rabbits-robotics/gamma_neck_pcb/docs/2026-08-12-gamma-neck-spec.md

# gamma_neck基板 設計スペック

日付: 2026-08-12
状態: **spec最終版（2026-08-12・案A承認済み・12回路割付確定・PH6P衝突はリスク受容・CAN1デバッグ口は不採用）**。残件: MHF5005最終確認（線序候補あり）・リング定格数値・コネクタ秋月コード・基板サイズ
KiCadプロジェクト: このフォルダの `gamma_neck.kicad_pro` を新設計で置き換える（現内容はコピーの名残・旧ガーバーはgbr_*.zipに保存済み）

## 1. 役割

マイコンなしの**受動基板**。砲塔側で以下を担う:
1. スリップリング（車体⇔砲塔）のリード線の受け口
2. 24V駆動電源の分配（首モータ3台・P4キャリア）
3. CANバスの分配（CAN1=砲塔系を首モータへ、CAN2=車体系をP4へパススルー）
4. 競技用ゲームモジュール線（4ピン）のパススルー

システム文脈: network_gamma.drawio参照。首=DM3507×2（Roll/Pitch）＋MHF5005（Yaw）の3軸ジンバル、制御はP4キャリア（gamma_turret）のCAN1。

## 2. 入出力とコネクタ

| 方向 | 系統 | コネクタ | 備考 |
|---|---|---|---|
| 入力（スリップリングから） | 24V駆動電源 | **PH 6P（24V×3+GND×3）確定** | リング12回路割付: 電源6・CAN2×2・PA4。旧Vin1と同構造。**PH3ピン並列=6A連続 — 合算負荷は紙上超過の可能性あるが実効平均の低さと旧構成実績でリスク受容（2026-08-12）** |
| 〃 | CAN2（車体バス） | PH 2P | |
| 〃 | ゲームモジュール線 | **PA 4P**（競技指定規格。電源2＋通信2） | |
| 出力 | DM3507 Roll用 電源 | **XT30メス** | **達妙転換板（SH1.0→XT30+GH1.25）経由に変更（2026-08-12）** — モータ側ピン数の疑問（8pin表記とユーザー認識6pinの食い違い）を転換板が吸収。XT30の15A級でピーク8.3Aも余裕 |
| 〃 | DM3507 Roll用 CAN1 | **PH 2P**（1=H/2=L） | 転換板のGH1.25出口を従来方式でPH化 |
| 〃 | DM3507 Pitch用 電源 | **XT30メス** | Roll同様 |
| 〃 | DM3507 Pitch用 CAN1 | **PH 2P** | Roll同様 |
| 〃 | MHF5005 Yaw用（電源+CAN1） | **PH 6P** | 転換板が無いため6pin直受け（1対1圧着）。電源2並列=4A — MHF5005の電流値確認後に検算 |
| 〃 | P4キャリアへ 24V | XT30（メス=供給側の作法） | P4側は24Vin1（XT30PW-Mオス） |
| 〃 | P4キャリアへ CAN1 | PH 2P | P4側CAN1コネクタ（PH2P）と対 |
| 〃 | P4キャリアへ CAN2 | PH 2P | パススルー中継 |
| 〃 | 競技モジュールへ | PA 4P | パススルー |
| 搭載（確定） | 24V通電LED | 緑LED＋10kΩ直列 | **turretと同色ルール（緑=電源）**。緑OSG5TA3Z74A（[秋月111635](https://akizukidenshi.com/catalog/g/g111635/)）を**1個追加購入**（turret D1は単品購入のため余りなし）。24Vで約2.1mA・抵抗損失44mW=1/4W可 |

## 3. CAN終端の方針（確定）

- **この基板には終端抵抗を載せない**
- CAN1: **モータ内蔵の切替式終端で運用**（DM3507=内蔵・デフォルトON〔マニュアル確認済み: 「终端电阻开关，默认打开」〕、MHF5005=切替可能〔ユーザー確認〕）。**運用ルール: バス最遠の1台のみON・他はOFF**。デフォルトONのまま3台繋ぐと120Ω×4並列=30Ωで規格外になるため、組立時のスイッチ確認を必須手順とする
- CAN2: 両端終端は車体側とP4キャリア（R9）が担当。この基板は分岐のみ

## 4. 設計上の注意

- 24V大電流経路（スリップリング入力→モータ3分岐＋P4分岐）は太パターン/ベタ。P4分岐はP4のDCDCout経由でESC×2＋サーボの電流も流れる点に注意
- PHの電源ピンは2A/ピン。並列本数×2Aで各口を検算（4.5節・上表に記載済み）。**コネクタ構成はP4向けXT30メスとゲームPA 4Pを除き全てPHファミリーに統一（2026-08-12）**
- 誤挿し対策: P4向けXT30はメス（供給側）で向き分け。PH 8P（DM3507×2）とPA 4Pはピン数で排除
- **⚠️リスク受容（2026-08-12ユーザー判断）**: リング電源入力とMHF5005出力が同じPH 6P — 挿し違えるとモータのCANピンに24V。対策なし・シルク表記＋組立時確認で運用担保
- PH 2P同士（CAN2入力・P4向けCAN1/CAN2）の挿し違えはCAN同士のため実害小（通信不成立のみ・破損なし）

## 4.5 DM3507実測仕様（2026-08-12マニュアル確認済み）

- **電源+CAN端子（SH1.0 8pin）の線序: 1〜3=VCC(24V)並列／4〜6=GND並列／7=CAN_L／8=CAN_H** → PH 8Pへ1対1付け替えでそのまま基板ピン配列になる
- **定格電源電流3.0A・ピーク8.3A/台**（額定0.8Nm・峰値3Nm・減速7:1）
- PH電源容量検算: 3ピン並列×2A=6A ≥ 定格3A → 成立（ピーク8.3Aは瞬時のため許容と判断）
- 終端抵抗: 物理スイッチOFF/ON式・デフォルトON（p3図で確認）
- 注意: マニュアルp2の付属品リストは8pin/3pinの記載が逆（誤記）。p3の接口説明が正: 電源+CAN=8pin、調試串口=3pin
- モータ搭載穴: 4×M3、外径46mm・高37.9mm・150g

## 5. 未確認事項（設計前に埋める）

1. ~~DM3507の線序~~ → **転換板経由に変更したため基板設計上は不問に（2026-08-12）**。8pin/6pinの食い違い（マニュアルp3=8pin図 vs ユーザー認識6pin）は現物確認を組立時に
2. MHF5005の6ピン線序 → **有力候補確定（旧gamma_neck基板の実績配線）: 1=CAN_L/2=CAN_H/3=GND/4=GND/5=24V/6=24V**。マニュアルで最終確認＋定格・ピーク電流の取得のみ残
2b. **CAN2の車体側終端の所在確認（新規）** — 旧システムは旧neck基板のR2が唯一のCAN2終端だった形跡（旧chassis/fuse_boxに終端なし）。新体制ではP4のR9が砲塔側終端になるため、車体側終端をどこが担うか（DM系ESC内蔵スイッチ等）の確認が必要
3. スリップリング → **12回路・割付確定（電源6/CAN2×2/PA4、2026-08-12）**。残るは**回路あたり定格電流の確認のみ**: 一般的な12回路カプセル品の2A/回路と仮定すると電源容量6A連続。DM3507×2の定格合算(6A)と同水準のため、型番判明次第数値を差し替える。※ジンバル用途の実効平均電流は定格よりかなり低いのが通例で、瞬時バーストはリングの熱容量で吸収される見込みだが、連続高負荷（保持トルク張り付き）時は注意
4. ~~秋月在庫~~ → **確定（2026-08-12・全て在庫あり）**:
   - PH 6P B6B-PH-K-S ×2（リング電源入力・MHF5005用）: [112806](https://akizukidenshi.com/catalog/g/g112806/)・¥15
   - PH 2P B2B-PH-K-S ×5（CAN2入力・P4向けCAN1/CAN2・Roll/Pitch CAN）: [112802](https://akizukidenshi.com/catalog/g/g112802/)・¥10
   - PA 4P B04B-PASK ×2（リング側・モジュール側）: [115012](https://akizukidenshi.com/catalog/g/g115012/)・¥20（ハーネス用ハウジングPAP-04V-S: [115009](https://akizukidenshi.com/catalog/g/g115009/)）
   - XT30PW-F ×3（P4向け24V出力・Roll/Pitch電源）: [117948](https://akizukidenshi.com/catalog/g/g117948/)・¥70
   - ※PH横出し（S□B）の多ピンは秋月非取扱のため**トップ型（縦）前提**。横出しが必須になったら要再検討
5. 基板サイズ・取付穴（首まわりの搭載スペース）
6. ゲームモジュール4ピンの通信種別（パススルーなので設計には影響しないが、記録として）

## 6. 実装方式の選択肢（→案Aで承認済み）

- **案A: 純受動・最小構成（採用）**: 上表のコネクタ＋太パターン＋24V通電LED（CAN1デバッグ口は2026-08-12不採用）
- 案B: 保守機能つき（各モータ電源にポリスイッチ・予備パッド追加）
- 案C: 割り切り軽量（スリップリング直はんだ）— 整備性が犠牲

## 7. 進め方（承認後）

gamma_turretと同じワークフロー: ユーザーがKiCadで手描き（当方はKiCadファイルに書き込まない）→ expected_nets.csv方式の結線照合＋ERC読み取り検証 → フットプリント全数監査 → レイアウト。
