rabbits-robotics/gamma_neck_pcb/docs/回路図作成リファレンス.md

# gamma_neck 回路リファレンス（現状版）

2026-08-12全面改訂: **完成した回路図の実際のrefdes・結線から生成**（照合済み: OK all nets match）。
設計判断の経緯は `2026-08-12-gamma-neck-spec.md`。初版（提案refdes版）はgit履歴参照。

## 1. 部品表（全15点・実際のrefdes）

| Ref | 部品 | フットプリント | 購入品 |
|---|---|---|---|
| Vin1 | リング電源入力 PH6P横 | `Connector_JST:JST_PH_S6B-PH-K_1x06_P2.00mm_Horizontal` | **[S6B-PH-K-S（千石EEHD-55FE・¥42/10個〜）](https://www.sengoku.co.jp/mod/sgk_cart/detail.php?code=EEHD-55FE)** ※秋月非取扱・生産遅延注記あり店頭在庫要確認 |
| YawMotor1 | MHF5005用 PH6P横 | 同上 | 同上（計2個） |
| Vout1〜Vout3 | 24V出力 XT30メス横×3（P4・Roll電源・Pitch電源） | `Connector_AMASS:AMASS_XT30PW-F_1x02_P2.50mm_Horizontal` | [XT30PW-F（秋月117948・¥70）](https://akizukidenshi.com/catalog/g/g117948/)×3 |
| CAN1_a/b/c | CAN1口×3（Roll・Pitch・P4） | `Connector_JST:JST_PH_B2B-PH-K_1x02_P2.00mm_Vertical` | [B2B-PH-K-S（秋月112802・¥10）](https://akizukidenshi.com/catalog/g/g112802/)×3 |
| CAN2_a1/b1 | CAN2パススルー（リング側/P4側） | 同上 | 同上×2 |
| GAME_MODULE | PA4P **1口・電気的未接続（確定）** | `User:JST_PA_B04B-PASK_1x04_P2.00mm_Vertical`（自作・検証済み・爪側シルク付き） | [B04B-PASK（秋月115012・¥20）](https://akizukidenshi.com/catalog/g/g115012/) |
| R1 | 120Ω CAN1終端 **DNP予定** | `Resistor_THT:R_Axial_DIN0204_L3.6mm_D1.6mm_P5.08mm_Horizontal` | 手持ちCF25J |
| R2 | 120Ω CAN2終端 **必ずDNP** | 同上 | 同上 |
| R3 | LED直列 **⚠️要修正: 1k→10k** | 同上 | 同上 |
| D1 | 24V通電LED 緑 | `LED_THT:LED_D3.0mm` | [OSG5TA3Z74A（秋月111635・¥20）](https://akizukidenshi.com/catalog/g/g111635/) |

**価格比較の結論（2026-08-12）**: 千石のPH系は一律¥42/個（10個〜）で、秋月在庫品（¥10〜15）より3〜4倍高い → **リンク差し替え対象なし。千石調達はS6B-PH-K-S（秋月非取扱品）のみ**。

## 2. 結線（照合済みの実体）

| ネット | 接続 |
|---|---|
| +24V | Vin1.4-6／Vout1-3の各2番／YawMotor1.5-6／R3.1 |
| GND | Vin1.1-3／Vout1-3の各1番／YawMotor1.3-4／D1.1 |
| CAN_H | CAN1_a/b/cの各1番／YawMotor1.2／R1.1 |
| CAN_L | CAN1_a/b/cの各2番／YawMotor1.1／R1.2 |
| CAN2（無名2本） | CAN2_a1⇔CAN2_b1の1番同士・2番同士＋R2 |
| LED | +24V→R3→D1(A)、D1(K)→GND |
| GAME_MODULE | 全ピン未接続（NC・ユーザー確定: ゲーム線は基板パターンを経由しない） |

## 3. 残作業（2026-08-12レビュー指摘）

1. **🔴 R3の値を1k→10kへ**（24Vで22mA・0.5W焼損リスク。10kで2.2mA/48mW）
2. **🟡 R1・R2にDNPフラグ**（プロパティ→「実装しない」。R2は必ずDNP。R1は「実装してモータ側全OFF運用」への変更も選択肢 — 決めたらspecに記録）
3. アノテーション警告（数字なしref: GAME_MODULE等）— 実害なし・任意

## 4. 検証

```bash
cd C:\Users\kota0\Desktop\Rabbits\board_ws\gamma_neck
python check_nets.py
```
現状: **OK: all nets match**（36接続）。ERCエラー2件（+24V/GND電源未駆動）は許容ベースライン。
