rabbits-robotics/gamma_neck_pcb/gamma_neck.step

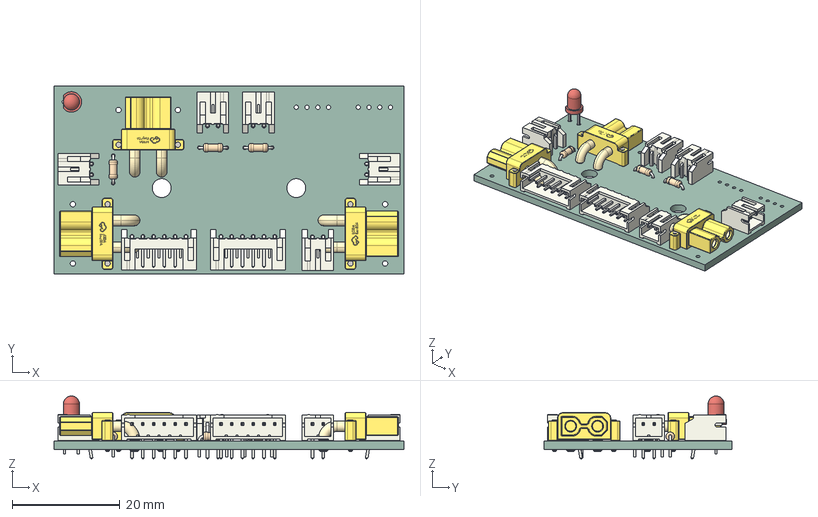
[picture p1: CAD file, 2026-10-18]
gamma_neck.step
65.0 x 35.0 x 11.7 mm
R_Axial_DIN0204_L36mm_D16mm_P508mm_Horizontal x 3
CONN-TH_XT30PW-F-1 x 3
JST_S2B_PH_K x 5
JST_S6B_PH_K x 2
LED_D3.0mm
gamma_neck_PCB
