rabbits-robotics/gamma_neck_pcb/(list of files, cad)

Other CAD files:
gamma_neck.DXF
