rabbits-robotics/gamma_neck_pcb/gamma_neck.pdf

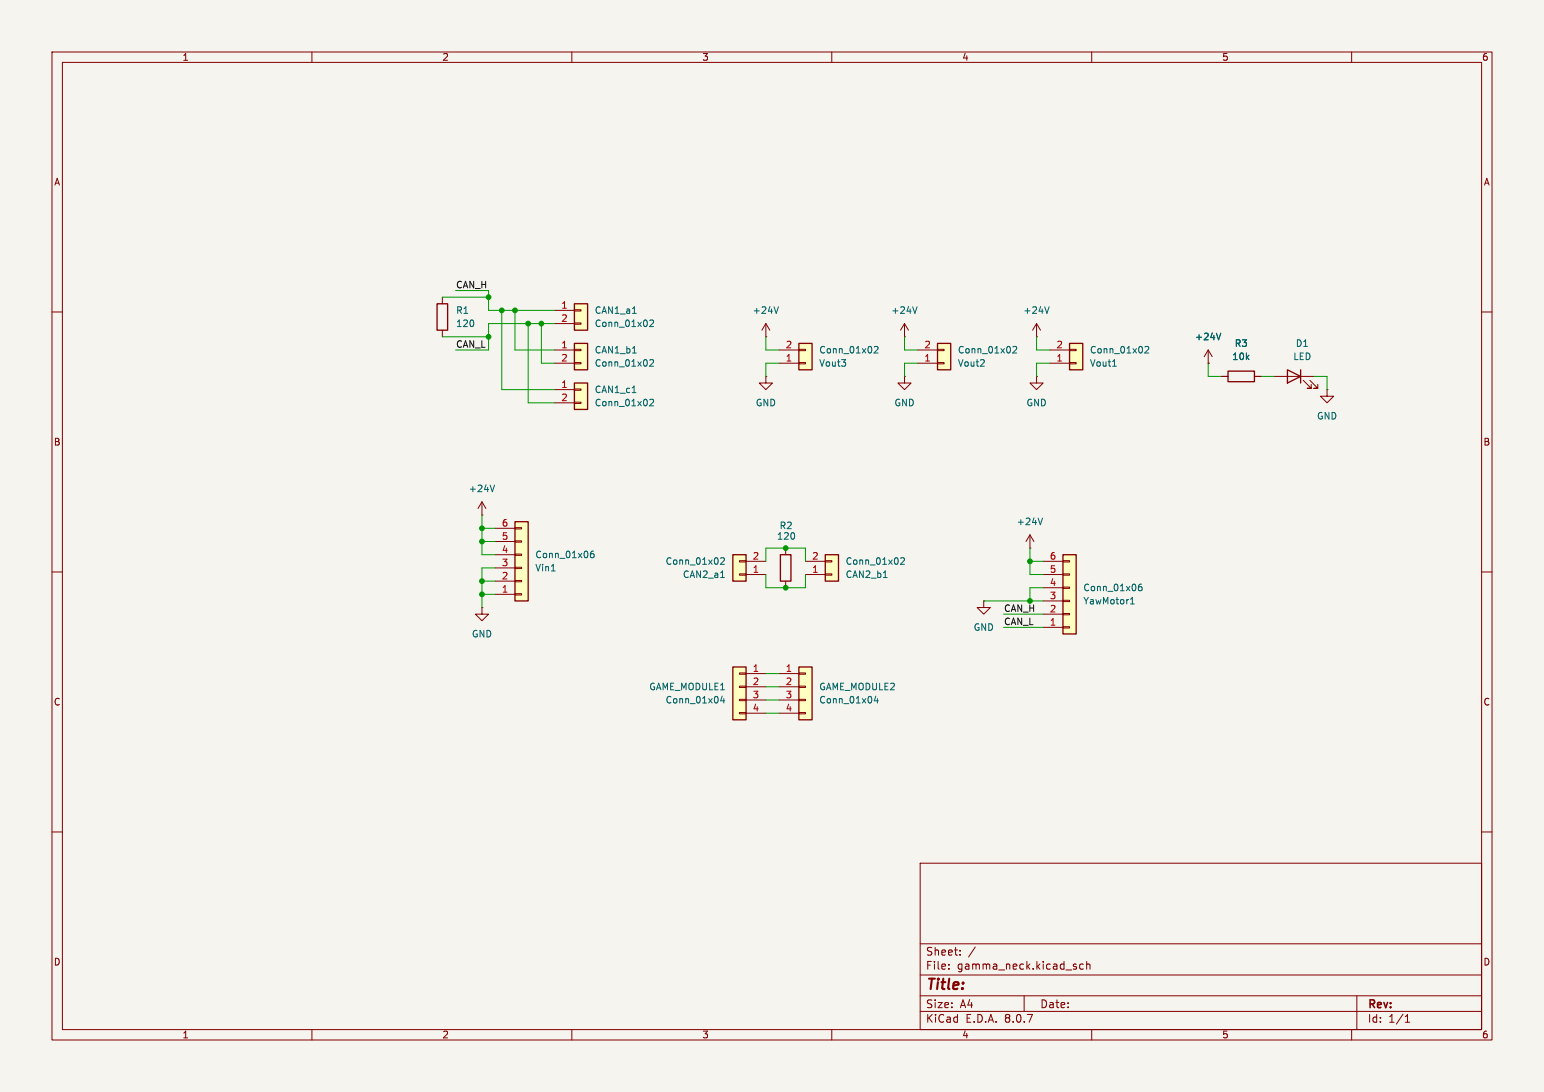
[picture p2: page 1]
