rabbits-robotics/gamma_neck_pcb/gamma_neck.kicad_sch

## KiCad design gamma_neck.kicad_sch (2026-10-18)

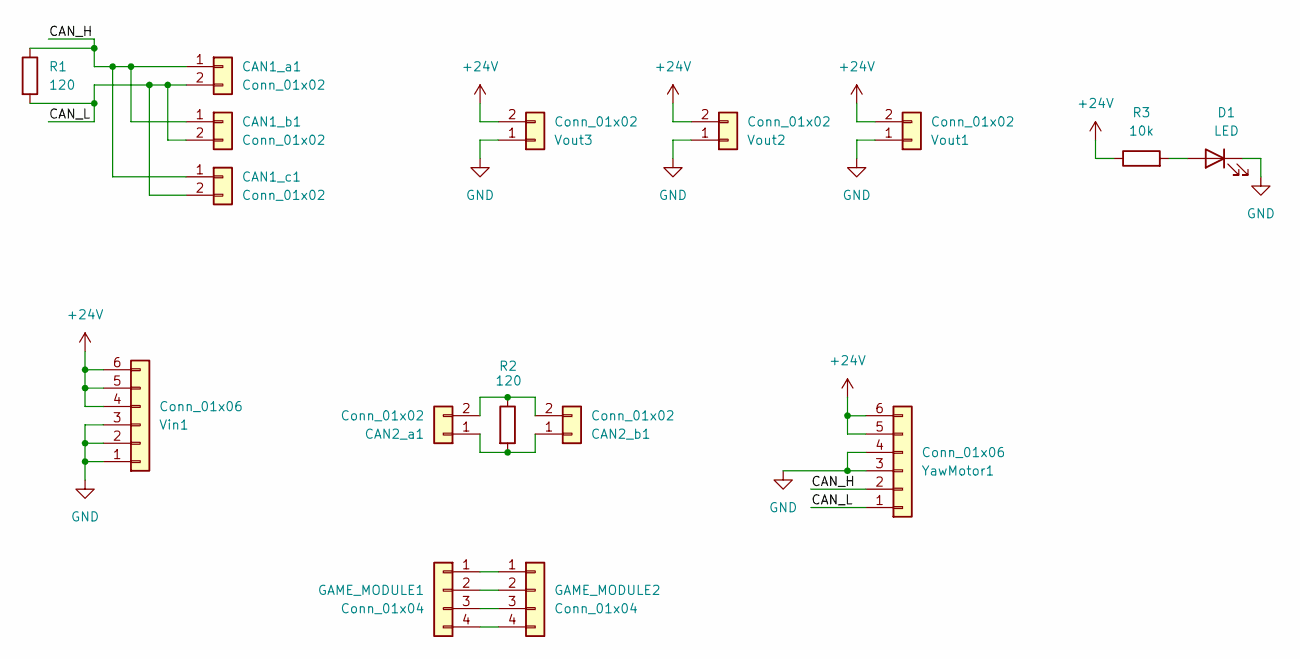
[picture p3: schematic gamma_neck.kicad_sch]

Parts:
CAN1_a1, CAN1_b1, CAN1_c1, CAN2_a1, CAN2_b1: Conn_01x02; JST_PH_S2B-PH-K_1x02_P2.00mm_Horizontal
D1: LED; LED_D3.0mm
GAME_MODULE1, GAME_MODULE2: Conn_01x04; JST_PA_B04B-PASK_1x04_P2.00mm_Vertical
R1, R2: 120; R_Axial_DIN0204_L3.6mm_D1.6mm_P5.08mm_Horizontal
R3: 10k; R_Axial_DIN0204_L3.6mm_D1.6mm_P5.08mm_Horizontal
Vin1: Conn_01x06; JST_PH_S6B-PH-K_1x06_P2.00mm_Horizontal
Vout1, Vout2, Vout3: Conn_01x02; AMASS_XT30PW-F_1x02_P2.50mm_Horizontal
YawMotor1: Conn_01x06; JST_PH_S6B-PH-K_1x06_P2.00mm_Horizontal

Connections:
+24V: R3.1, Vin1.4, Vin1.5, Vin1.6, Vout1.2, Vout2.2, Vout3.2, YawMotor1.5, YawMotor1.6
CAN_H: CAN1_a1.1, CAN1_b1.1, CAN1_c1.1, R1.1, YawMotor1.2
CAN_L: CAN1_a1.2, CAN1_b1.2, CAN1_c1.2, R1.2, YawMotor1.1
GND: D1.1 (K), Vin1.1, Vin1.2, Vin1.3, Vout1.1, Vout2.1, Vout3.1, YawMotor1.3, YawMotor1.4
unnamed: CAN2_a1.1, CAN2_b1.1, R2.2
unnamed: CAN2_a1.2, CAN2_b1.2, R2.1
unnamed: D1.2 (A), R3.2
unnamed: GAME_MODULE1.1, GAME_MODULE2.1
unnamed: GAME_MODULE1.2, GAME_MODULE2.2
unnamed: GAME_MODULE1.3, GAME_MODULE2.3
unnamed: GAME_MODULE1.4, GAME_MODULE2.4
